polyrhythmic-glider/ADLFO-project/hardware/pcb/viewer-template.html

ADLFO hardware lab

REV A · PROPOSTA

Una PCB. Quattro canali indipendenti.

# Dal prototipo al pannello.

Un front panel forato davanti, una sola scheda dietro. Comandi sul lato frontale; Daisy, DAC, condizionamento e alimentazione sul retro. Geometria, fori, distinta e collegamenti derivano dagli stessi sorgenti.

PanoramicaEsploso 3DPannelloPCBForatura

Mostra reti da sbrogliareDistanza Rotazione

{{FRONT}}01 / Front panel

{{BACK}}02 / PCB · vista posteriore

{{PCBFRONT}}

{{FRONT}}

Vista spaziale illustrativa · superfici derivate dal CAD · altezze dei componenti da verificare

{{FRONT}}

{{BACK}}

{{RATSNEST}}

{{CUT}}

Anteprima dei componenti semplificata. Il disegno della PCB mostra le piazzole reali del file KiCad; le linee nella vista «reti» sono collegamenti logici, non piste in rame.

24 HPPannello 121,6 × 128,5 mm

1 PCB116,6 × 110,5 mm · 2 lati

4 + 4 + 12Encoder, pulsanti, jack

0–5 V*Obiettivo uscite a vuoto

## La disposizione

OLED in alto, quattro encoder RISE / FALL / SYMMETRY / LEVEL, quattro pulsanti per scegliere il canale. Sotto: TRIG, CV IN e OUT, organizzati per colonne e colore.

I quattro encoder modificano il canale selezionato: le loro funzioni non corrispondono ai quattro canali. Il pannello lo distingue con due gruppi di etichette.

## L'elettronica proposta

- Daisy Seed rimovibile su zoccolo, MCP4728 sulla PCB.
- CV 0–10 V con partitore, clamp e buffer MCP6004.
- Trigger invertenti a transistor; ingressi normalizzati a massa.
- TL074 su alimentazione duale, guadagno 2,5.
- Ingresso Eurorack ±12 V, convertitore RECOM a 5 V.

Stato: progetto preliminare, PCB non sbrogliata. Prima della produzione servono routing, controllo ERC/DRC in KiCad, verifica delle impronte sul materiale reale e collaudo elettrico/meccanico. Display e pulsanti sono ingombri assunti. Il distacco pannello/PCB di 10 mm è provvisorio. * Con 2,2 kΩ in serie, 5 V a vuoto diventano circa 4,89 V su 100 kΩ. Il firmware attuale mantiene gli ingressi disabilitati.

PCB KiCadSchema KiCadPannello DXFDima PDF 1:1Immagine progettoDistinta CSVModello OpenSCADNote di progetto

Esplora i {{COUNT}} componenti e le coordinate

Riferimento | Componente / valore | Lato | X, Y (mm dal pannello)

{{BOM}}

Generato con KiUtils + librerie KiCad / AudioJacks + SVGwrite + ezdxf. Il visualizzatore funziona offline. Nessun file Gerber di produzione emesso.
