polyrhythmic-glider/ADLFO-project/hardware/pcb/output/index.html

ADLFO hardware lab

REV A · PROPOSTA

Una PCB. Quattro canali indipendenti.

# Dal prototipo al pannello.

Un front panel forato davanti, una sola scheda dietro. Comandi sul lato frontale; Daisy, DAC, condizionamento e alimentazione sul retro. Geometria, fori, distinta e collegamenti derivano dagli stessi sorgenti.

PanoramicaEsploso 3DPannelloPCBForatura

Mostra reti da sbrogliareDistanza Rotazione

01 / Front panel

02 / PCB · vista posteriore

Vista spaziale illustrativa · superfici derivate dal CAD · altezze dei componenti da verificare

Anteprima dei componenti semplificata. Il disegno della PCB mostra le piazzole reali del file KiCad; le linee nella vista «reti» sono collegamenti logici, non piste in rame.

24 HPPannello 121,6 × 128,5 mm

1 PCB116,6 × 110,5 mm · 2 lati

4 + 4 + 12Encoder, pulsanti, jack

0–5 V*Obiettivo uscite a vuoto

## La disposizione

OLED in alto, quattro encoder RISE / FALL / SYMMETRY / LEVEL, quattro pulsanti per scegliere il canale. Sotto: TRIG, CV IN e OUT, organizzati per colonne e colore.

I quattro encoder modificano il canale selezionato: le loro funzioni non corrispondono ai quattro canali. Il pannello lo distingue con due gruppi di etichette.

## L'elettronica proposta

- Daisy Seed rimovibile su zoccolo, MCP4728 sulla PCB.
- CV 0–10 V con partitore, clamp e buffer MCP6004.
- Trigger invertenti a transistor; ingressi normalizzati a massa.
- TL074 su alimentazione duale, guadagno 2,5.
- Ingresso Eurorack ±12 V, convertitore RECOM a 5 V.

Stato: progetto preliminare, PCB non sbrogliata. Prima della produzione servono routing, controllo ERC/DRC in KiCad, verifica delle impronte sul materiale reale e collaudo elettrico/meccanico. Display e pulsanti sono ingombri assunti. Il distacco pannello/PCB di 10 mm è provvisorio. * Con 2,2 kΩ in serie, 5 V a vuoto diventano circa 4,89 V su 100 kΩ. Il firmware attuale mantiene gli ingressi disabilitati.

PCB KiCadSchema KiCadPannello DXFDima PDF 1:1Immagine progettoDistinta CSVModello OpenSCADNote di progetto

Esplora i 114 componenti e le coordinate

Riferimento | Componente / valore | Lato | X, Y (mm dal pannello)
U1 | Daisy Seed (socketed) | B | 82, 24
U2 | MCP4728-E/UN | B | 87, 60
U3 | MCP6004-I/SL | B | 35, 59
U4 | TL074CDR | B | 61, 59
U5 | R-78E5.0-0.5 | B | 31, 24
J13 | EURORACK 2x5 keyed | B | 10.5, 25
J14 | OLED SSD1306 128x64 | F | 29, 11
D1 | SS14 | B | 21, 36
D2 | SS14 | B | 30, 36
D3 | SS14 | B | 42, 24
C1 | 10uF 50V X7R | B | 20, 29
C2 | 10uF 50V X7R | B | 30, 31
C3 | 10uF 10V X7R | B | 40, 29
C4 | 10uF 10V X7R | B | 49.5, 24
C5 | 100nF | B | 81.5, 56
C6 | 10uF 10V X7R | B | 81.5, 64.5
C7 | 100nF | B | 28, 59
C8 | 100nF 50V | B | 54, 59
C9 | 100nF 50V | B | 61, 52.5
R1 | 4.7k | B | 43, 16
R2 | 4.7k | B | 43, 19.5
TP1 | GND | B | 10, 43
TP2 | +12VA | B | 16, 43
TP3 | -12VA | B | 34, 43
TP4 | +5V_SEED | B | 40, 36
TP5 | +3V3 | B | 47, 36
ENC1 | RISE | F | 22, 48
SW1 | CH 1 | F | 22, 67
J1 | TRIG1 | F | 22, 80
J2 | CV1 | F | 22, 95
J3 | OUT1 | F | 22, 110
R101 | 100k | B | 15, 77
R102 | 1M | B | 15, 81
R103 | 47k | B | 15, 85
Q1 | MMBT3904 | B | 28, 80
D101 | 1N4148W | B | 28, 85
R104 | 100k 0.1% | B | 15, 92
R105 | 33k 0.1% | B | 15, 96
R106 | 10k | B | 15, 100
C101 | 10nF | B | 28, 90
D102 | BAT54S | B | 28, 94
R107 | 1k | B | 28, 99
C102 | 1nF | B | 28, 103
R108 | 10k | B | 15, 56
R109 | 10k 0.1% | B | 15, 60
R110 | 15k 0.1% | B | 15, 64
R111 | 2.2k 0.5W | B | 29, 110
TP11 | DAC1 | B | 15, 70
ENC2 | FALL | F | 48, 48
SW2 | CH 2 | F | 48, 67
J4 | TRIG2 | F | 48, 80
J5 | CV2 | F | 48, 95
J6 | OUT2 | F | 48, 110
R201 | 100k | B | 41, 77
R202 | 1M | B | 41, 81
R203 | 47k | B | 41, 85
Q2 | MMBT3904 | B | 54, 80
D201 | 1N4148W | B | 54, 85
R204 | 100k 0.1% | B | 41, 92
R205 | 33k 0.1% | B | 41, 96
R206 | 10k | B | 41, 100
C201 | 10nF | B | 54, 90
D202 | BAT54S | B | 54, 94
R207 | 1k | B | 54, 99
C202 | 1nF | B | 54, 103
R208 | 10k | B | 41, 56
R209 | 10k 0.1% | B | 41, 60
R210 | 15k 0.1% | B | 41, 64
R211 | 2.2k 0.5W | B | 55, 110
TP12 | DAC2 | B | 41, 70
ENC3 | SYMMETRY | F | 74, 48
SW3 | CH 3 | F | 74, 67
J7 | TRIG3 | F | 74, 80
J8 | CV3 | F | 74, 95
J9 | OUT3 | F | 74, 110
R301 | 100k | B | 67, 77
R302 | 1M | B | 67, 81
R303 | 47k | B | 67, 85
Q3 | MMBT3904 | B | 80, 80
D301 | 1N4148W | B | 80, 85
R304 | 100k 0.1% | B | 67, 92
R305 | 33k 0.1% | B | 67, 96
R306 | 10k | B | 67, 100
C301 | 10nF | B | 80, 90
D302 | BAT54S | B | 80, 94
R307 | 1k | B | 80, 99
C302 | 1nF | B | 80, 103
R308 | 10k | B | 67, 56
R309 | 10k 0.1% | B | 67, 60
R310 | 15k 0.1% | B | 67, 64
R311 | 2.2k 0.5W | B | 81, 110
TP13 | DAC3 | B | 67, 70
ENC4 | LEVEL | F | 100, 48
SW4 | CH 4 | F | 100, 67
J10 | TRIG4 | F | 100, 80
J11 | CV4 | F | 100, 95
J12 | OUT4 | F | 100, 110
R401 | 100k | B | 93, 77
R402 | 1M | B | 93, 81
R403 | 47k | B | 93, 85
Q4 | MMBT3904 | B | 106, 80
D401 | 1N4148W | B | 106, 85
R404 | 100k 0.1% | B | 93, 92
R405 | 33k 0.1% | B | 93, 96
R406 | 10k | B | 93, 100
C401 | 10nF | B | 106, 90
D402 | BAT54S | B | 106, 94
R407 | 1k | B | 106, 99
C402 | 1nF | B | 106, 103
R408 | 10k | B | 93, 56
R409 | 10k 0.1% | B | 93, 60
R410 | 15k 0.1% | B | 93, 64
R411 | 2.2k 0.5W | B | 107, 110
TP14 | DAC4 | B | 93, 70

Generato con KiUtils + librerie KiCad / AudioJacks + SVGwrite + ezdxf. Il visualizzatore funziona offline. Nessun file Gerber di produzione emesso.
