polyrhythmic-glider/ADLFO-project/hardware/pcb/output/panel-drilling-1to1.pdf

# ADLFO · 24 HP

121.6 × 128.5 mm

DIMA 1:1 · QUOTE DA VERIFICARE SUI COMPONENTI
