polyrhythmic-glider/ADLFO-project/DaisyMonoEnvelope/ui-preview.png

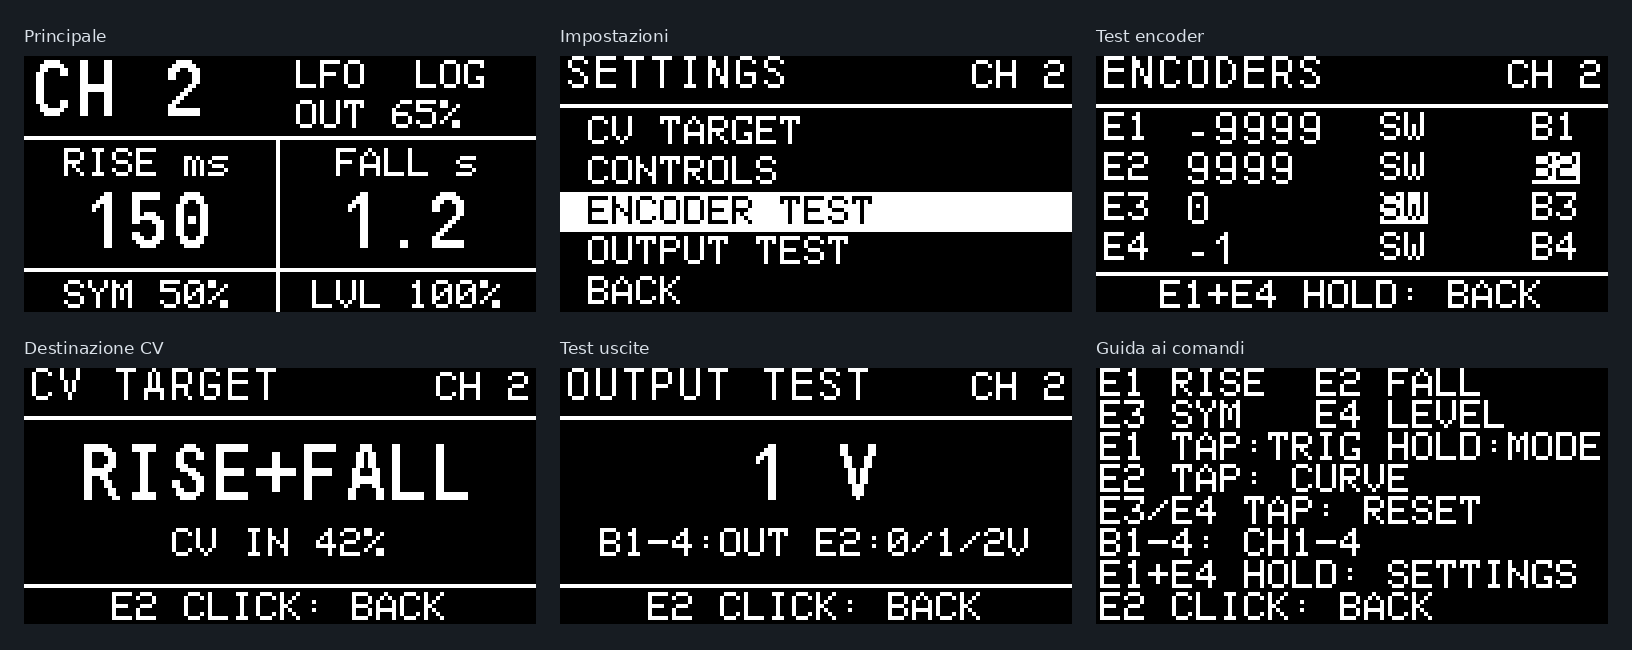
DaisyMonoEnvelope/ui-preview.png
