polyrhythmic-glider/ADLFO-project/hardware/pcb/output/overview.png

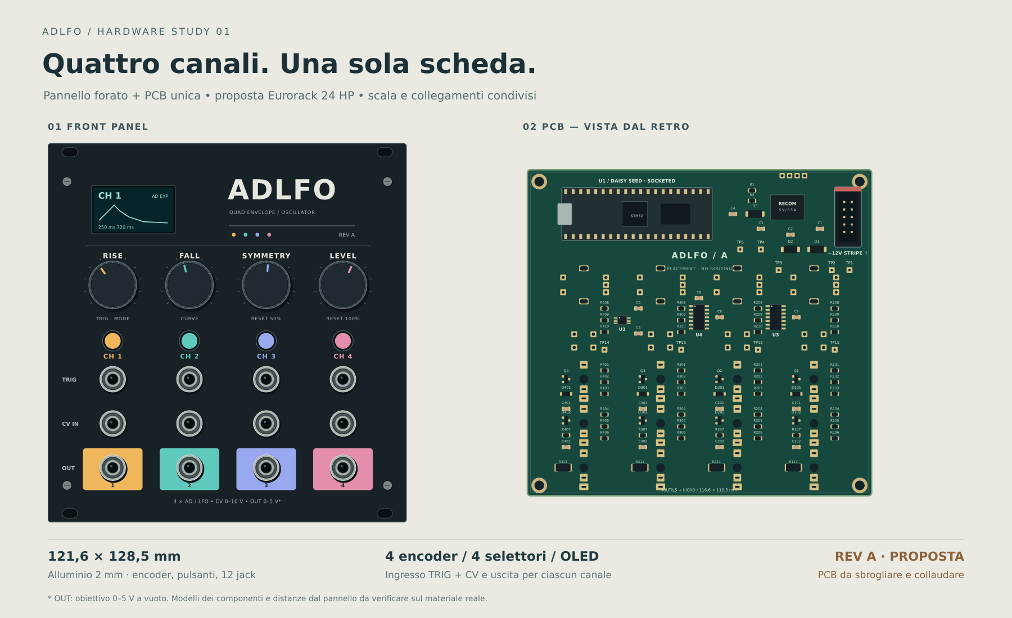
hardware/pcb/output/overview.png
