polyrhythmic-glider/ADLFO-project/hardware/pcb/output/front-panel.dxf

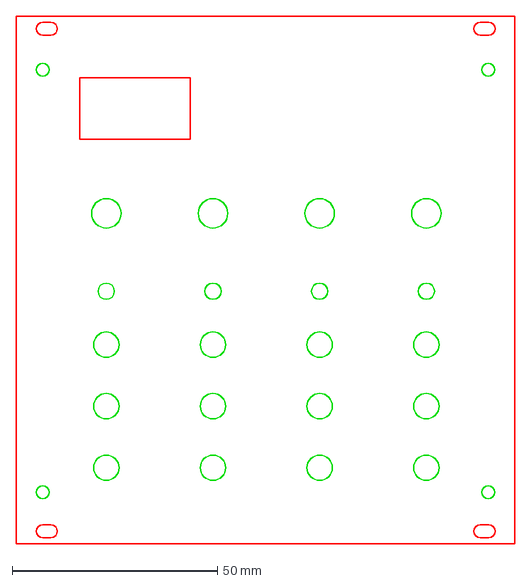
[picture p3: CAD file, 2026-10-22]
hardware/pcb/output/front-panel.dxf
121.6 x 128.5 mm
