polyrhythmic-glider/ADLFO-project/wiring/out_tl074/breadboard_mcp4728_tl074_4out.pdf

# ADLFO | MCP4728 + TL074 + 4 jack OUT

## Stadio finale previsto: DAC 0–2 V → guadagno 2,5 → OUT circa 0–5 V a vuoto

Vista dall’alto · proposta foro per foro da collaudare · nessun collegamento ai CV IN

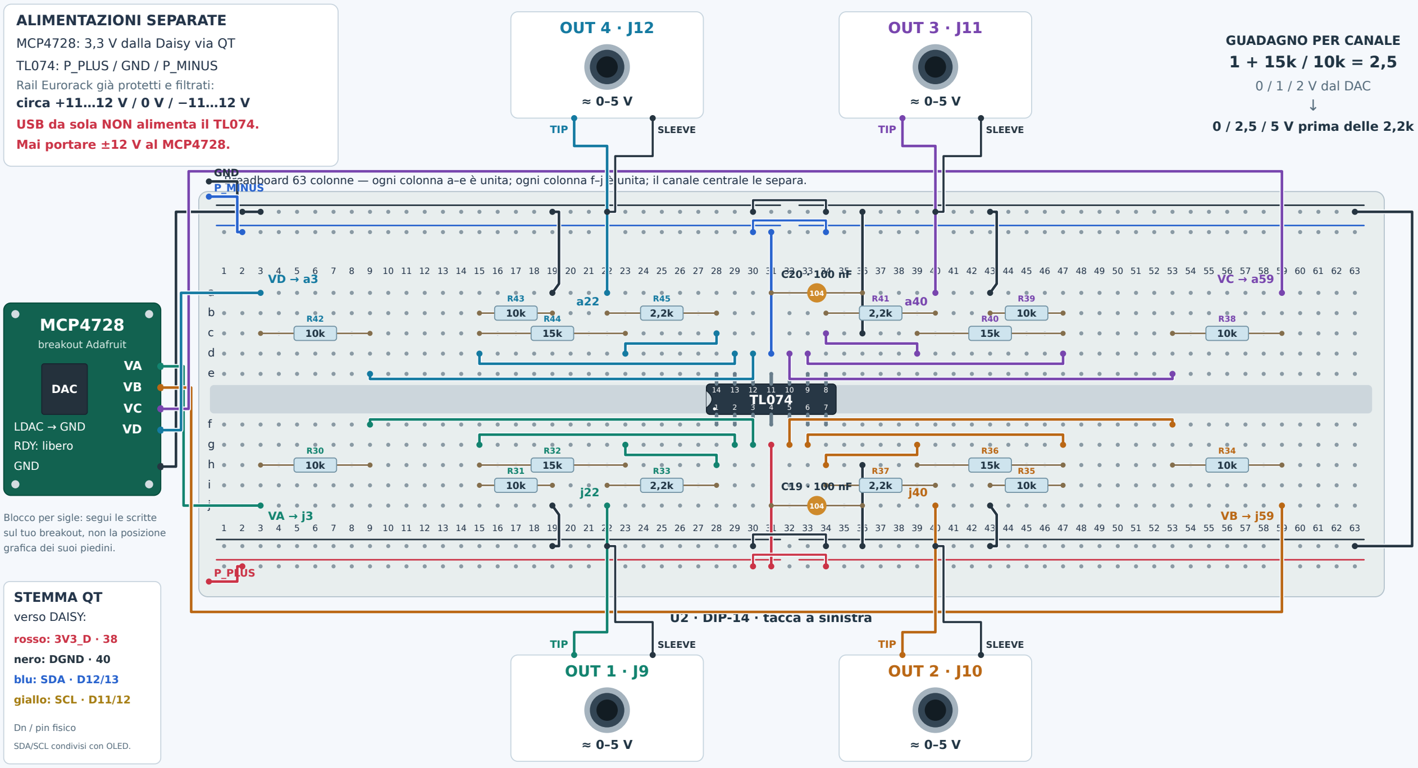
[picture p6: figure]
ALIMENTAZIONI SEPARATE; MCP4728: 3,3 V dalla Daisy via QT; TL074: P_PLUS / GND / P_MINUS; Rail Eurorack già protetti e filtrati: circa +11…12 V / 0 V / −11…12 V; USB da sola NON alimenta il TL074. Mai portare ±12 V al MCP4728.; U2 · DIP-14 · tacca a sinistra; MCP4728; breakout Adafruit; DAC; LDAC → GND; RDY: libero; GND; Blocco per sigle: segui le scritte sul tuo breakout, non la posizione grafica dei suoi piedini.; STEMMA QT; verso DAISY:; rosso: 3V3_D · 38; nero: DGND · 40; blu: SDA · D12/13; giallo: SCL · D11/12; Dn / pin fisico; SDA/SCL condivisi con OLED.; GND P_MINUS; P_PLUS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

Breadboard 63 colonne — ogni colonna a–e è unita; ogni colonna f–j è unita; il canale centrale le separa.

### TG · GND TN · −12 V*

### BG · GND BP · +12 V*

* Rail dopo le protezioni
P_PLUS / P_MINUS.

Etichetta le barre
come nel disegno.

### GND ≠ −12 V

Ponti 30 ↔ 34:
uniscono le due metà
di ciascuna barra.

TG e BG sono unite
dal filo a destra.

Punti pieni = terminali nei fori. Incroci senza punto = fili isolati, NON giunzioni. Resistenze 1%; le 2,2k sono da 0,5 W.

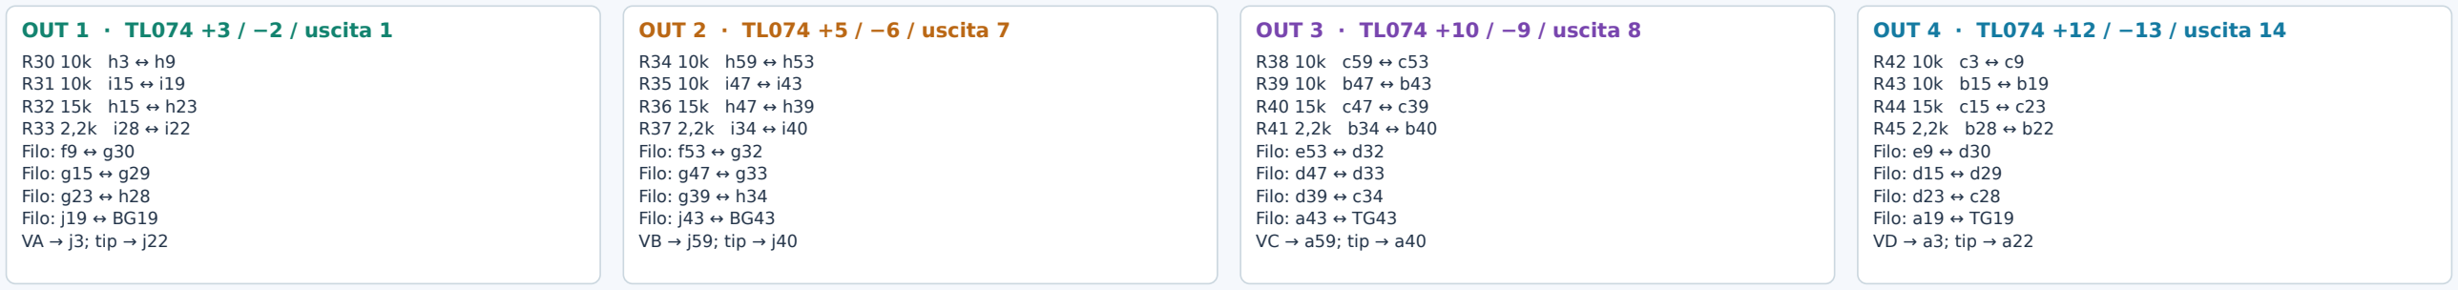
[picture p7: figure]
OUT 1 · TL074 +3 / −2 / uscita 1; R30 10k h3 ↔ h9 R31 10k i15 ↔ i19 R32 15k h15 ↔ h23 R33 2,2k i28 ↔ i22 Filo: f9 ↔ g30 Filo: g15 ↔ g29 Filo: g23 ↔ h28 Filo: j19 ↔ BG19 VA → j3; tip → j22; OUT 2 · TL074 +5 / −6 / uscita 7; R34 10k h59 ↔ h53 R35 10k i47 ↔ i43 R36 15k h47 ↔ h39 R37 2,2k i34 ↔ i40 Filo: f53 ↔ g32 Filo: g47 ↔ g33 Filo: g39 ↔ h34 Filo: j43 ↔ BG43 VB → j59; tip → j40; OUT 3 · TL074 +10 / −9 / uscita 8; R38 10k c59 ↔ c53 R39 10k b47 ↔ b43 R40 15k c47 ↔ c39 R41 2,2k b34 ↔ b40 Filo: e53 ↔ d32 Filo: d47 ↔ d33 Filo: d39 ↔ c34 Filo: a43 ↔ TG43 VC → a59; tip → a40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

U2: pin 1…7 = f28…f34; pin 14…8 = e28…e34. Pin 4 → P_PLUS; pin 11 → P_MINUS. Feedback 15k PRIMA della 2,2k.
C19: j31–j36, C20: a31–a36, entrambi 100 nF / ≥50 V verso GND. Alimentazione protetta/filtrata a monte non disegnata.
Quattro uscite; verificare il firmware effettivamente caricato. Montaggio non ancora collaudato contro errori di patch, ESD o modulo spento.
