polyrhythmic-glider/ADLFO-project/wiring/cv_in/schema.png

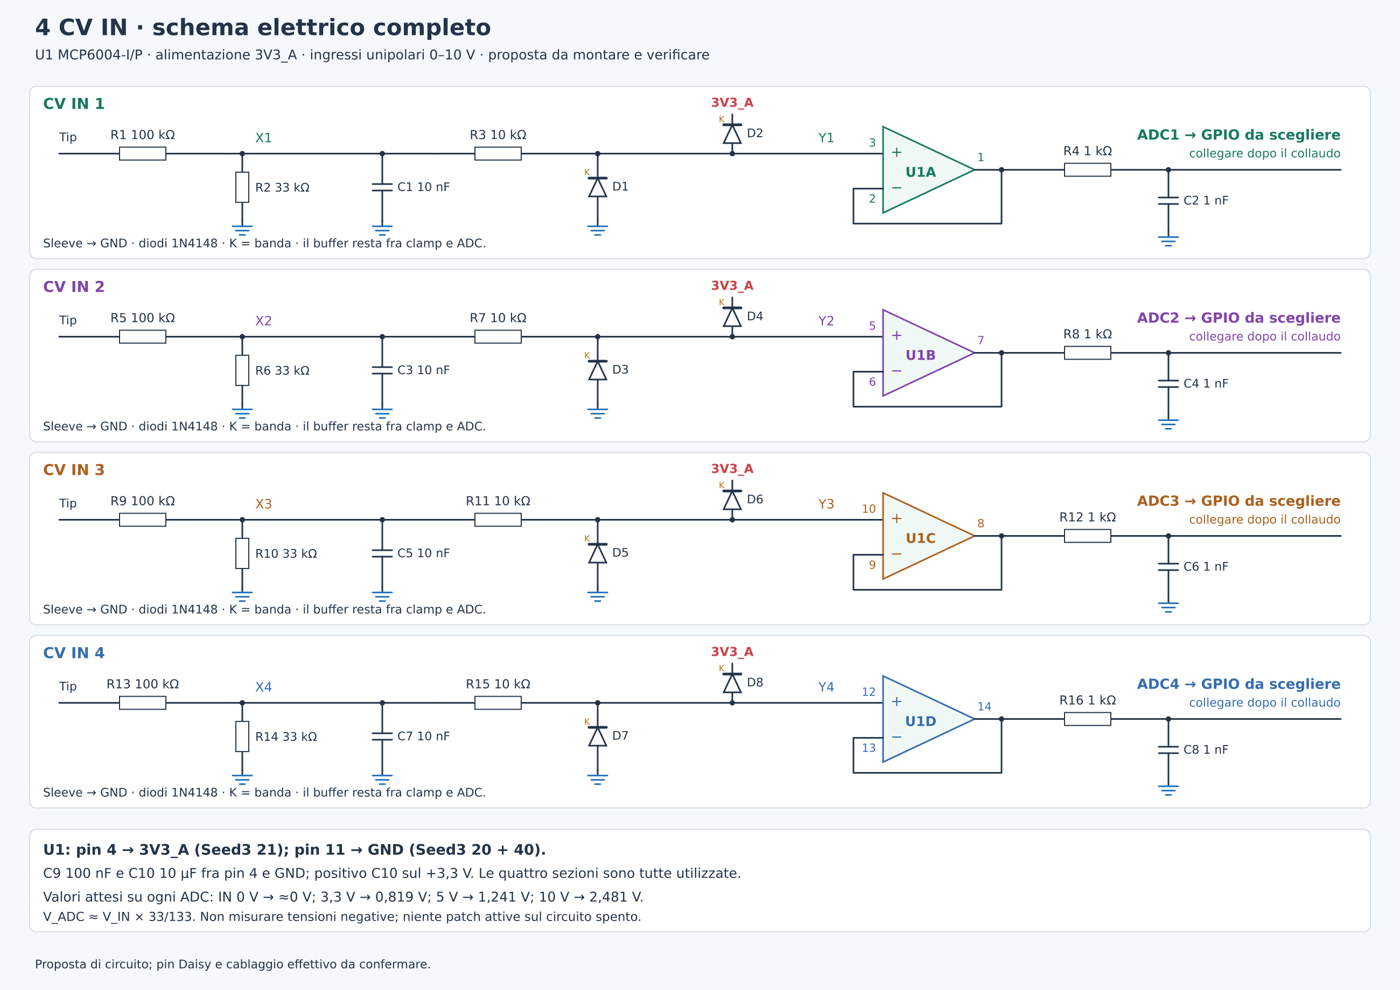
wiring/cv_in/schema.png
