polyrhythmic-glider/ADLFO-project/wiring/misure/fnirsi_trigger_2026-10-12_3.png

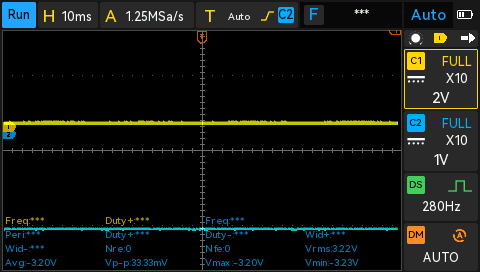
wiring/misure/fnirsi_trigger_2026-10-12_3.png
