polyrhythmic-glider/ADLFO-project/wiring/out_tl074/breadboard_mcp4728_tl074_4out.png

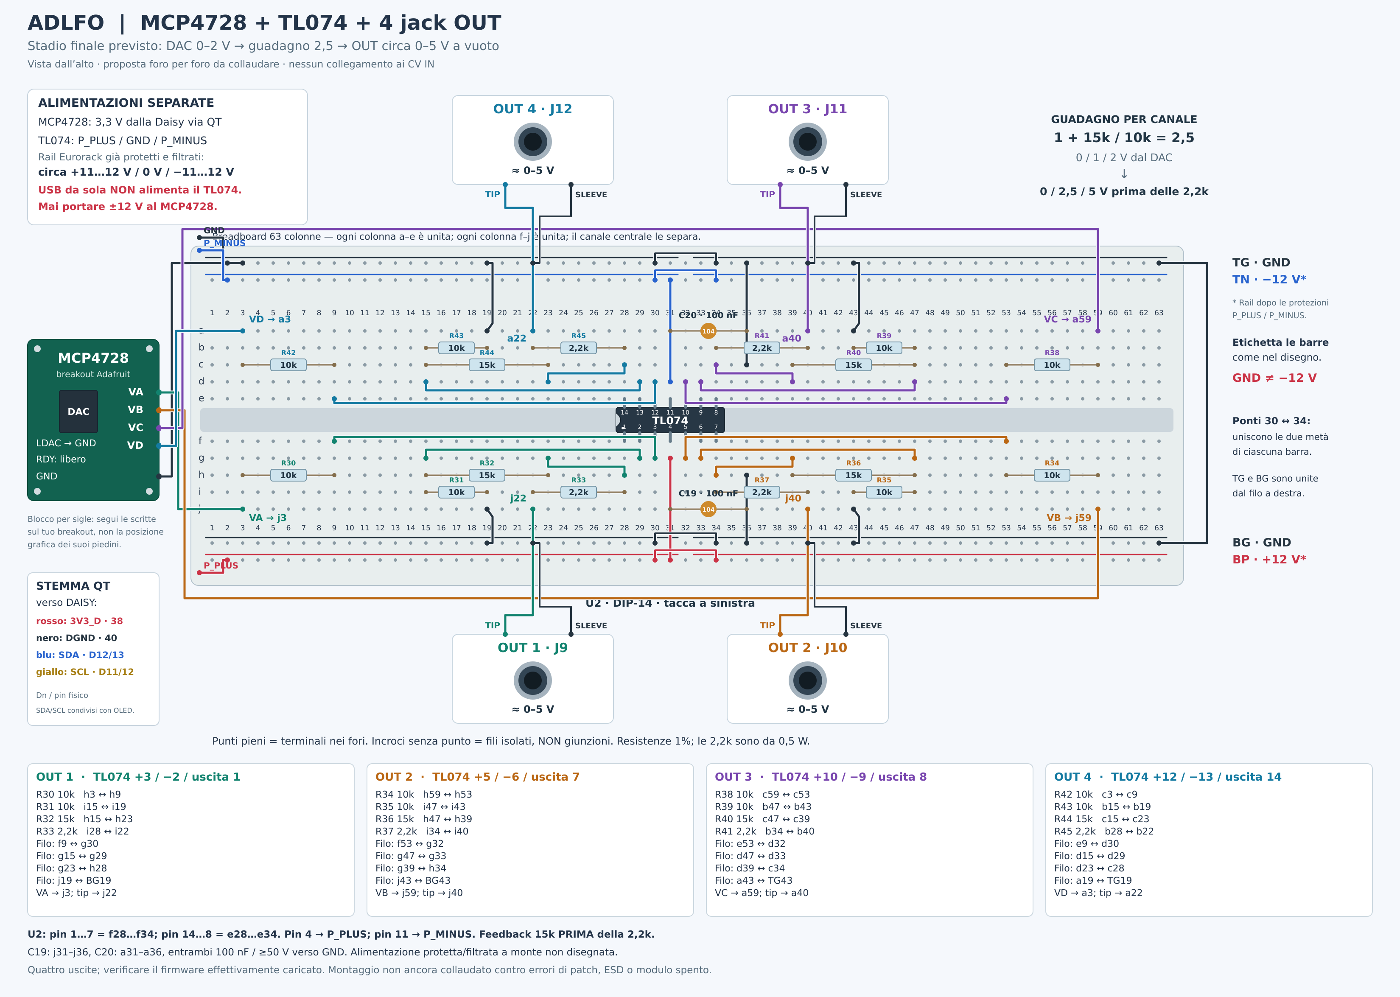
wiring/out_tl074/breadboard_mcp4728_tl074_4out.png
