polyrhythmic-glider/ADLFO-project/DaisyCv4Test/README.md

# Diagnostica separata

Vecchia prova CV/DAC, non il firmware ADLFO corrente.
Usare [il firmware principale](../DaisyMonoEnvelope/README.md).
