polyrhythmic-glider/ADLFO-project/DaisyOledTest/README.md

# Diagnostica OLED

Programma separato per il display; sostituisce il firmware ADLFO se caricato.
Firmware corrente: [DaisyMonoEnvelope](../DaisyMonoEnvelope/README.md).
