polyrhythmic-glider/ADLFO-project/hardware/pcb/output/ADLFO.kicad_pcb

## KiCad design hardware/pcb/output/ADLFO.kicad_pcb (2026-10-22)

Schematic: ADLFO.kicad_sch, ADLFO REV A — electrical placement draft

Parts:
C1, C2: 10uF 50V X7R; c0805
C3, C4, C6: 10uF 10V X7R; c0805
C5, C7: 100nF; c0805
C8, C9: 100nF 50V; c0805
C101, C201, C301, C401: 10nF; c0805
C102, C202, C302, C402: 1nF; c0805
D1, D2, D3: SS14; sma
D101, D201, D301, D401: 1N4148W; sod123
D102, D202, D302, D402: BAT54S; sot23
ENC1: RISE; encoder
ENC2: FALL; encoder
ENC3: SYMMETRY; encoder
ENC4: LEVEL; encoder
J1: TRIG1; jack
J2: CV1; jack
J3: OUT1; jack
J4: TRIG2; jack
J5: CV2; jack
J6: OUT2; jack
J7: TRIG3; jack
J8: CV3; jack
J9: OUT3; jack
J10: TRIG4; jack
J11: CV4; jack
J12: OUT4; jack
J13: EURORACK 2x5 keyed; idc10
J14: OLED SSD1306 128x64; oled
Q1, Q2, Q3, Q4: MMBT3904; sot23
R1, R2: 4.7k; r0805
R101, R201, R301, R401: 100k; r0805
R102, R202, R302, R402: 1M; r0805
R103, R203, R303, R403: 47k; r0805
R104, R204, R304, R404: 100k 0.1%; r0805
R105, R205, R305, R405: 33k 0.1%; r0805
R106, R108, R206, R208, R306, R308, R406, R408: 10k; r0805
R107, R207, R307, R407: 1k; r0805
R109, R209, R309, R409: 10k 0.1%; r0805
R110, R210, R310, R410: 15k 0.1%; r0805
R111, R211, R311, R411: 2.2k 0.5W; r2010
SW1: CH 1; button
SW2: CH 2; button
SW3: CH 3; button
SW4: CH 4; button
TP1: GND; testpoint
TP2: +12VA; testpoint
TP3: -12VA; testpoint
TP4: +5V_SEED; testpoint
TP5: +3V3; testpoint
TP11: DAC1; testpoint
TP12: DAC2; testpoint
TP13: DAC3; testpoint
TP14: DAC4; testpoint
U1: Daisy Seed (socketed); seed
U2: MCP4728-E/UN; msop10
U3: MCP6004-I/SL; soic14
U4: TL074CDR; soic14
U5: R-78E5.0-0.5; recom

Connections:
+3V3: C5.1, C6.1, C7.1, D102.2, D202.2, D302.2, D402.2, J14.2, R1.1, R2.1, R103.1, R203.1, R303.1, R403.1, TP5.1, U1.38 (+3V3), U2.1 (VDD), U3.4
+5V_REG: C3.1, D3.2, U5.3
+5V_SEED: C4.1, D3.1, TP4.1, U1.39 (+5V_SEED)
+12VA: C1.1, C8.1, D1.1, TP2.1, U4.4, U5.1
+12V_IN: D1.2, J13.9, J13.10
-12VA: C2.2, C9.1, D2.2, TP3.1, U4.11
-12V_IN: D2.1, J13.1, J13.2
CV1: J2.T, R104.1
CV2: J5.T, R204.1
CV3: J8.T, R304.1
CV4: J11.T, R404.1
CV_BUF1: R107.1, U3.1, U3.2
CV_BUF2: R207.1, U3.6, U3.7
CV_BUF3: R307.1, U3.8, U3.9
CV_BUF4: R407.1, U3.13, U3.14
CV_CLAMP1: D102.3, R106.2, U3.3
CV_CLAMP2: D202.3, R206.2, U3.5
CV_CLAMP3: D302.3, R306.2, U3.10
CV_CLAMP4: D402.3, R406.2, U3.12
CV_DIV1: C101.1, R104.2, R105.1, R106.1
CV_DIV2: C201.1, R204.2, R205.1, R206.1
CV_DIV3: C301.1, R304.2, R305.1, R306.1
CV_DIV4: C401.1, R404.2, R405.1, R406.1
D0: ENC1.A, U1.1 (D0)
D1: ENC1.B, U1.2 (D1)
D2: ENC1.S1, U1.3 (D2)
D3: ENC2.A, U1.4 (D3)
D4: ENC2.B, U1.5 (D4)
D5: ENC2.S1, U1.6 (D5)
D6: Q1.3, R103.2, U1.7 (D6)
D7: ENC3.A, U1.8 (D7)
D8: ENC3.B, U1.9 (D8)
D9: ENC3.S1, U1.10 (D9)
D10: ENC4.A, U1.11 (D10)
D11: J14.3, R1.2, U1.12 (D11), U2.2 (SCL)
D12: J14.4, R2.2, U1.13 (D12), U2.3 (SDA)
D13: ENC4.B, U1.14 (D13)
D14: ENC4.S1, U1.15 (D14)
D15: C102.1, R107.2, U1.22 (D15)
D16: C202.1, R207.2, U1.23 (D16)
D17: C302.1, R307.2, U1.24 (D17)
D18: C402.1, R407.2, U1.25 (D18)
D19: Q2.3, R203.2, U1.26 (D19)
D20: Q3.3, R303.2, U1.27 (D20)
D21: Q4.3, R403.2, U1.28 (D21)
D24: SW2.1, U1.31 (D24)
D25: SW1.1, U1.32 (D25)
D26: SW3.1, U1.33 (D26)
D27: SW4.1, U1.34 (D27)
DAC1: R108.1, TP11.1, U2.6 (VA)
DAC2: R208.1, TP12.1, U2.7 (VB)
DAC3: R308.1, TP13.1, U2.8 (VC)
DAC4: R408.1, TP14.1, U2.9 (VD)
GND: C1.2, C2.1, C3.2, C4.2, C5.2, C6.2, C7.2, C8.2, C9.2, C101.2, C102.2, C201.2, C202.2, C301.2, C302.2, C401.2, C402.2, D101.2, D102.1, D201.2, D202.1, D301.2, D302.1, D401.2, D402.1, ENC1.C, ENC1.MP, ENC1.S2, ENC2.C, ENC2.MP, ENC2.S2, ENC3.C, ENC3.MP, ENC3.S2, ENC4.C, ENC4.MP, ENC4.S2, J1.S, J1.TN, J2.S, J2.TN, J3.S, J4.S, J4.TN, J5.S, J5.TN, J6.S, J7.S, J7.TN, J8.S, J8.TN, J9.S, J10.S, J10.TN, J11.S, J11.TN, J12.S, J13.3, J13.4, J13.5, J13.6, J13.7, J13.8, J14.1, Q1.2, Q2.2, Q3.2, Q4.2, R102.2, R105.2, R109.2, R202.2, R205.2, R209.2, R302.2, R305.2, R309.2, R402.2, R405.2, R409.2, SW1.2, SW2.2, SW3.2, SW4.2, TP1.1, U1.20 (GND), U1.40 (GND), U2.4 (LDAC), U2.10 (VSS), U3.11, U5.2
OUT1: J3.T, R111.2
OUT2: J6.T, R211.2
OUT3: J9.T, R311.2
OUT4: J12.T, R411.2
OUT_AMP1: R110.1, R111.1, U4.1
OUT_AMP2: R210.1, R211.1, U4.7
OUT_AMP3: R310.1, R311.1, U4.8
OUT_AMP4: R410.1, R411.1, U4.14
OUT_FB1: R109.1, R110.2, U4.2
OUT_FB2: R209.1, R210.2, U4.6
OUT_FB3: R309.1, R310.2, U4.9
OUT_FB4: R409.1, R410.2, U4.13
OUT_PLUS1: R108.2, U4.3
OUT_PLUS2: R208.2, U4.5
OUT_PLUS3: R308.2, U4.10
OUT_PLUS4: R408.2, U4.12
TRIG1: J1.T, R101.1
TRIG2: J4.T, R201.1
TRIG3: J7.T, R301.1
TRIG4: J10.T, R401.1
TRIG_BASE1: D101.1, Q1.1, R101.2, R102.1
TRIG_BASE2: D201.1, Q2.1, R201.2, R202.1
TRIG_BASE3: D301.1, Q3.1, R301.2, R302.1
TRIG_BASE4: D401.1, Q4.1, R401.2, R402.1

Notes on the sheet:
SYSTEM / terminal net schematic
CH1 / terminal net schematic
CH2 / terminal net schematic
CH3 / terminal net schematic
CH4 / terminal net schematic

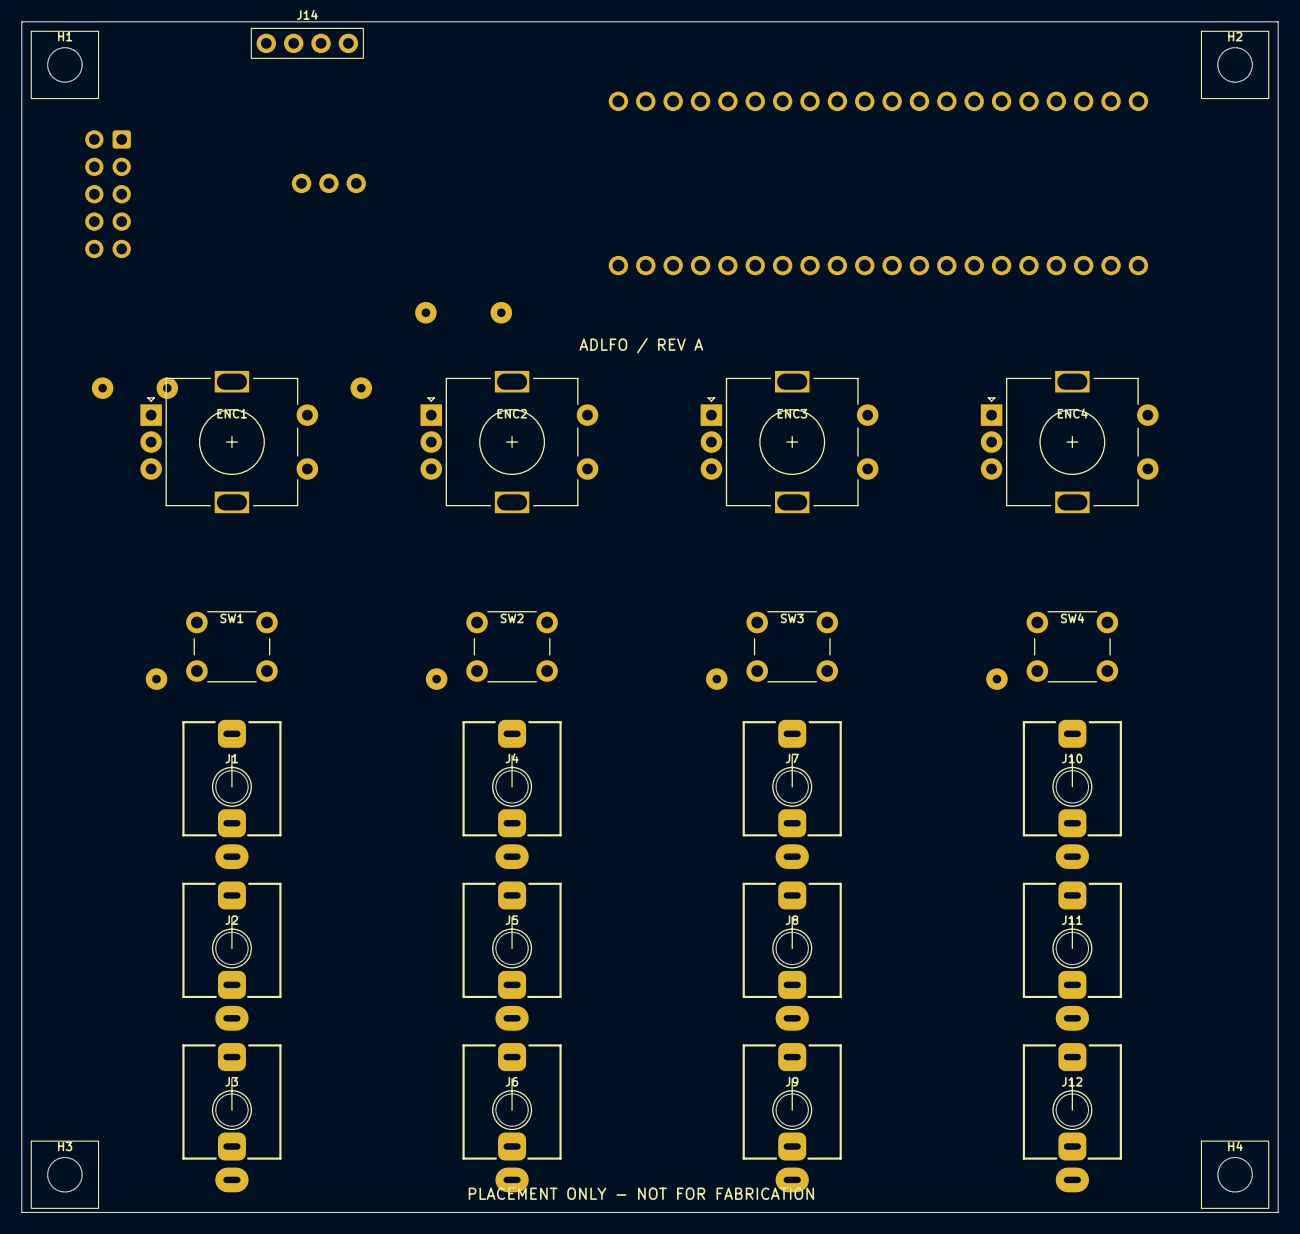
[picture p14: board ADLFO.kicad_pcb from above]

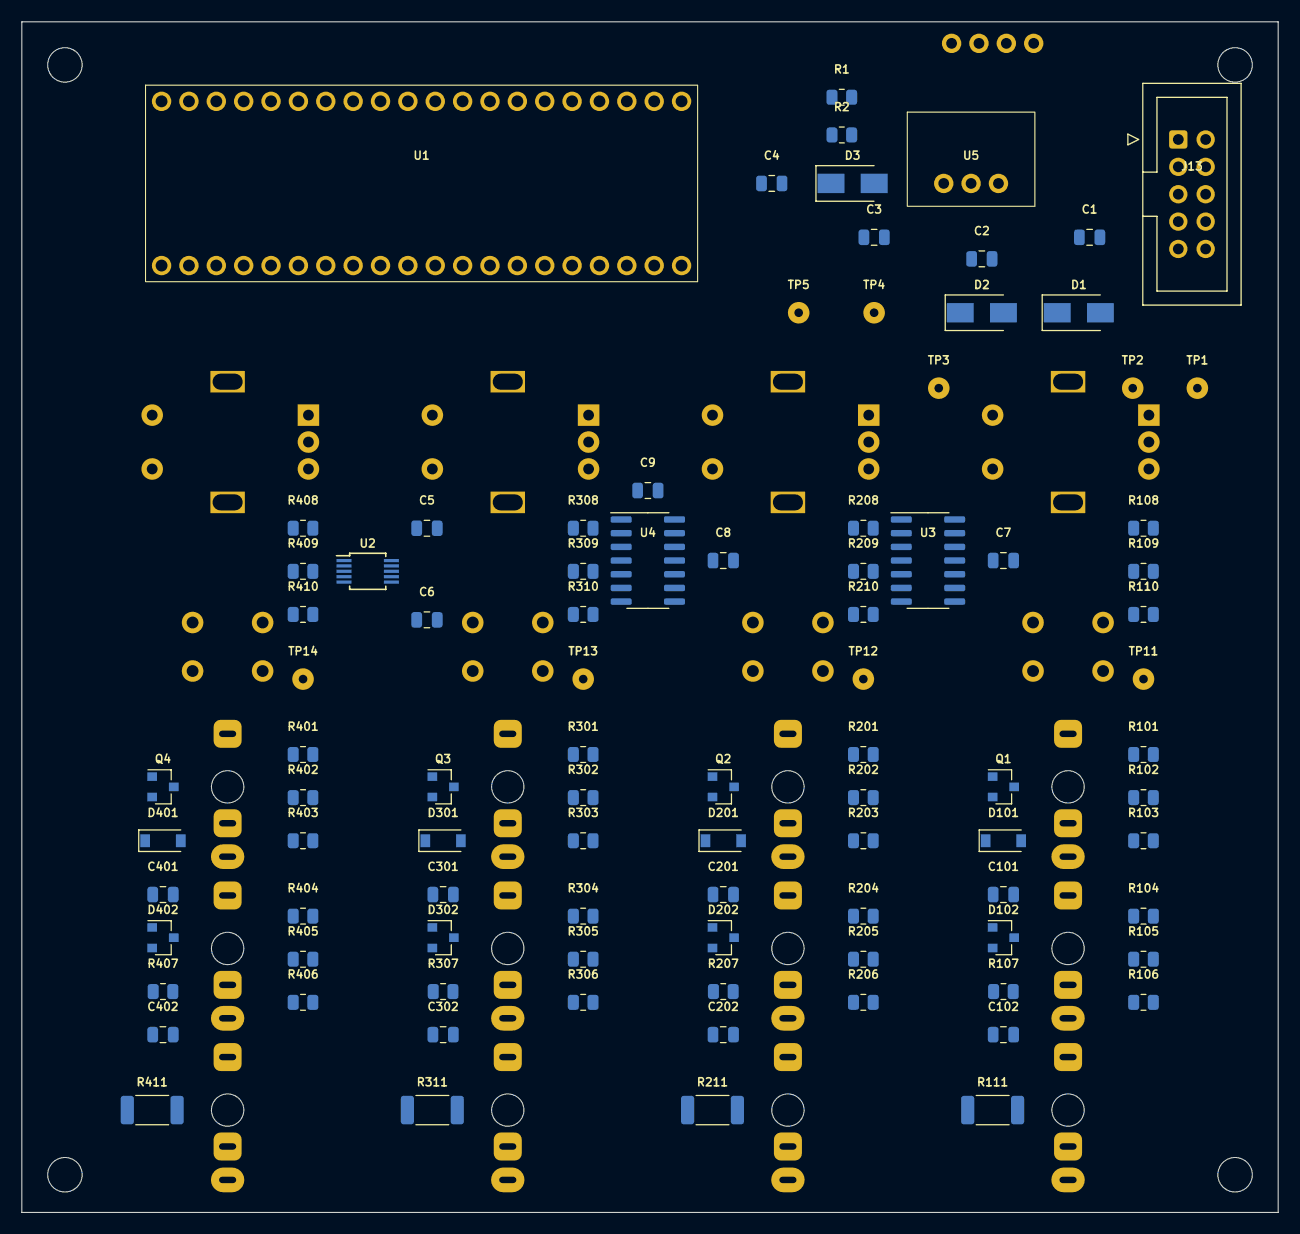
[picture p15: board ADLFO.kicad_pcb from below]

Board: 2 copper layers, 116.6 x 110.5 mm, 118 parts (93 on the bottom side), 78 nets, no tracks yet.

Other parts of the board:
H1, H2, H3, H4: M3 spacer; mount
