polyrhythmic-glider/ADLFO-project/(commit log)

2026-10-07 chore: big work brosky
    [BOM_COMPONENTI.csv]
2026-10-22 docs(wiring): add breadboard diagrams and consolidate hardware notes
    [BOM_COMPONENTI.csv]
2026-10-22 feat(hardware): add PCB generators and offline design viewer
2026-10-22 docs(hardware): add regenerated KiCad design and review exports
    [ADLFO.kicad_pcb, ADLFO.kicad_sch, assembly.scad, bom.csv, front-panel.dxf, panel-holes.csv, placement.csv]
